knox-101/boldfit-gallon-cap/preview/02_vault_cap.png

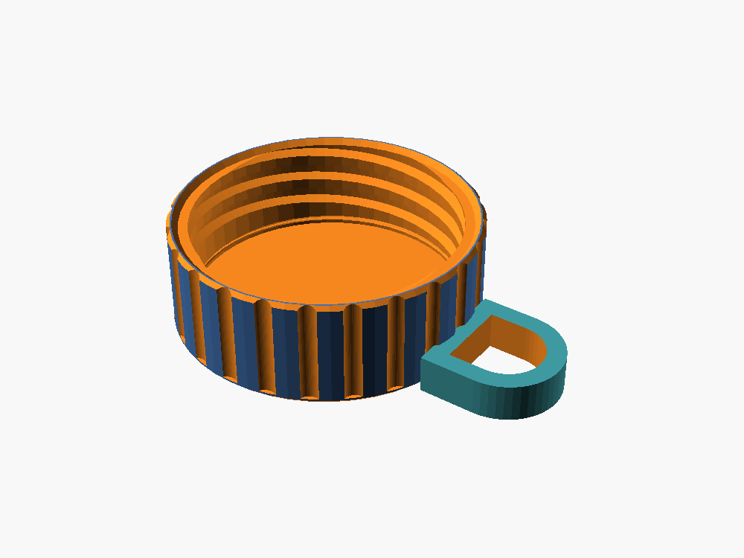
preview/02_vault_cap.png
