knox-101/boldfit-gallon-cap/preview/03_flip_base.png

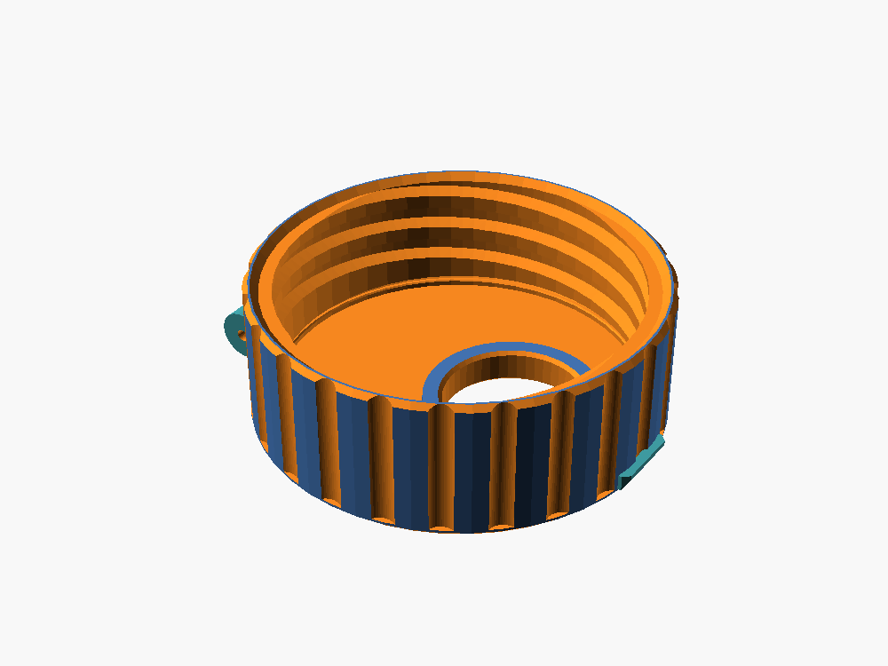
preview/03_flip_base.png
