knox-101/boldfit-gallon-cap/preview/03_flip_lid.png

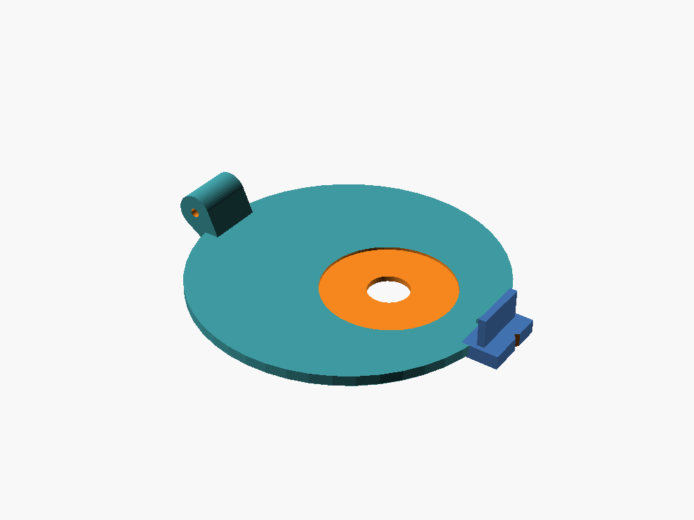
preview/03_flip_lid.png
