knox-101/boldfit-gallon-cap/preview/03_flip_seal_tpu.png

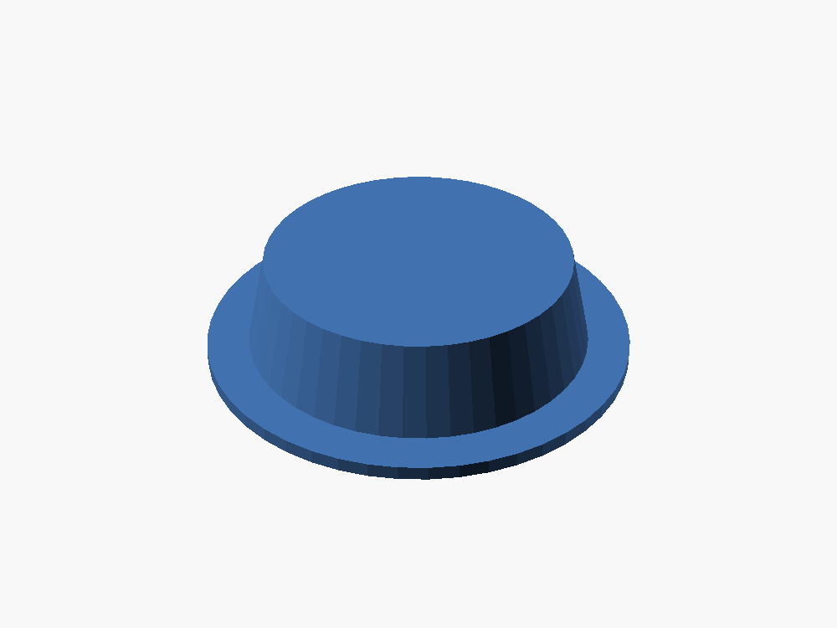
preview/03_flip_seal_tpu.png
