knox-101/boldfit-gallon-cap/preview/04_port_cap.png

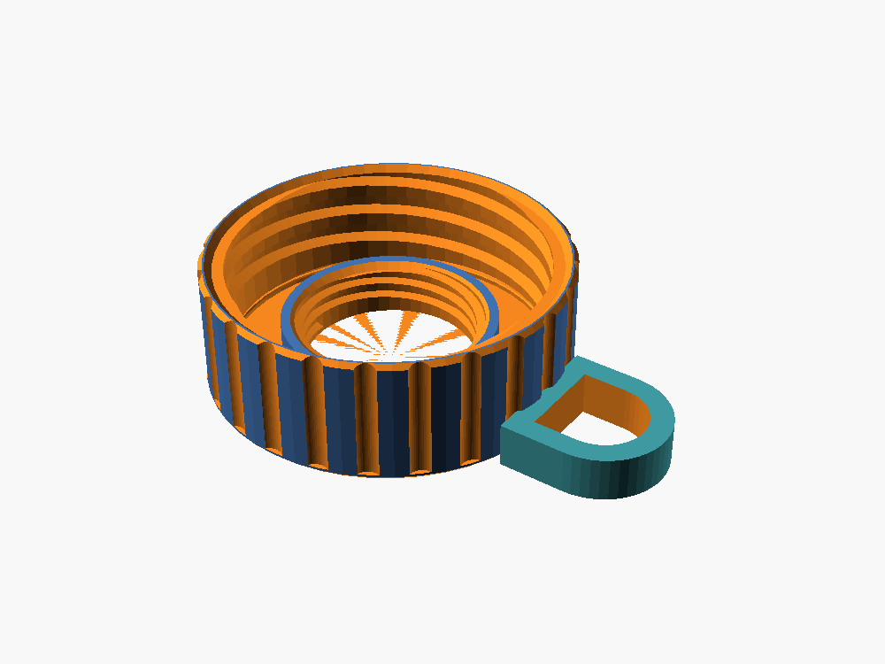
preview/04_port_cap.png
