knox-101/boldfit-gallon-cap/preview/04_port_gasket.png

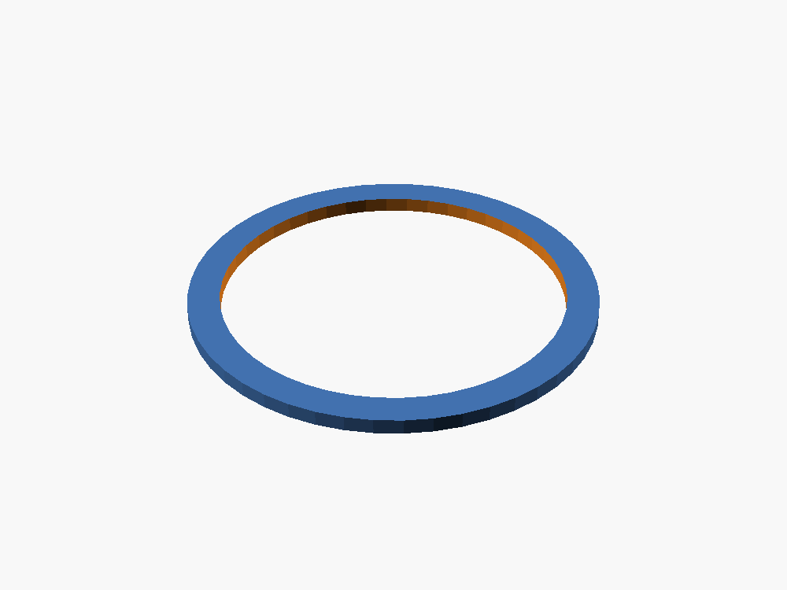
preview/04_port_gasket.png
