knox-101/boldfit-gallon-cap/preview/sections_2d.png

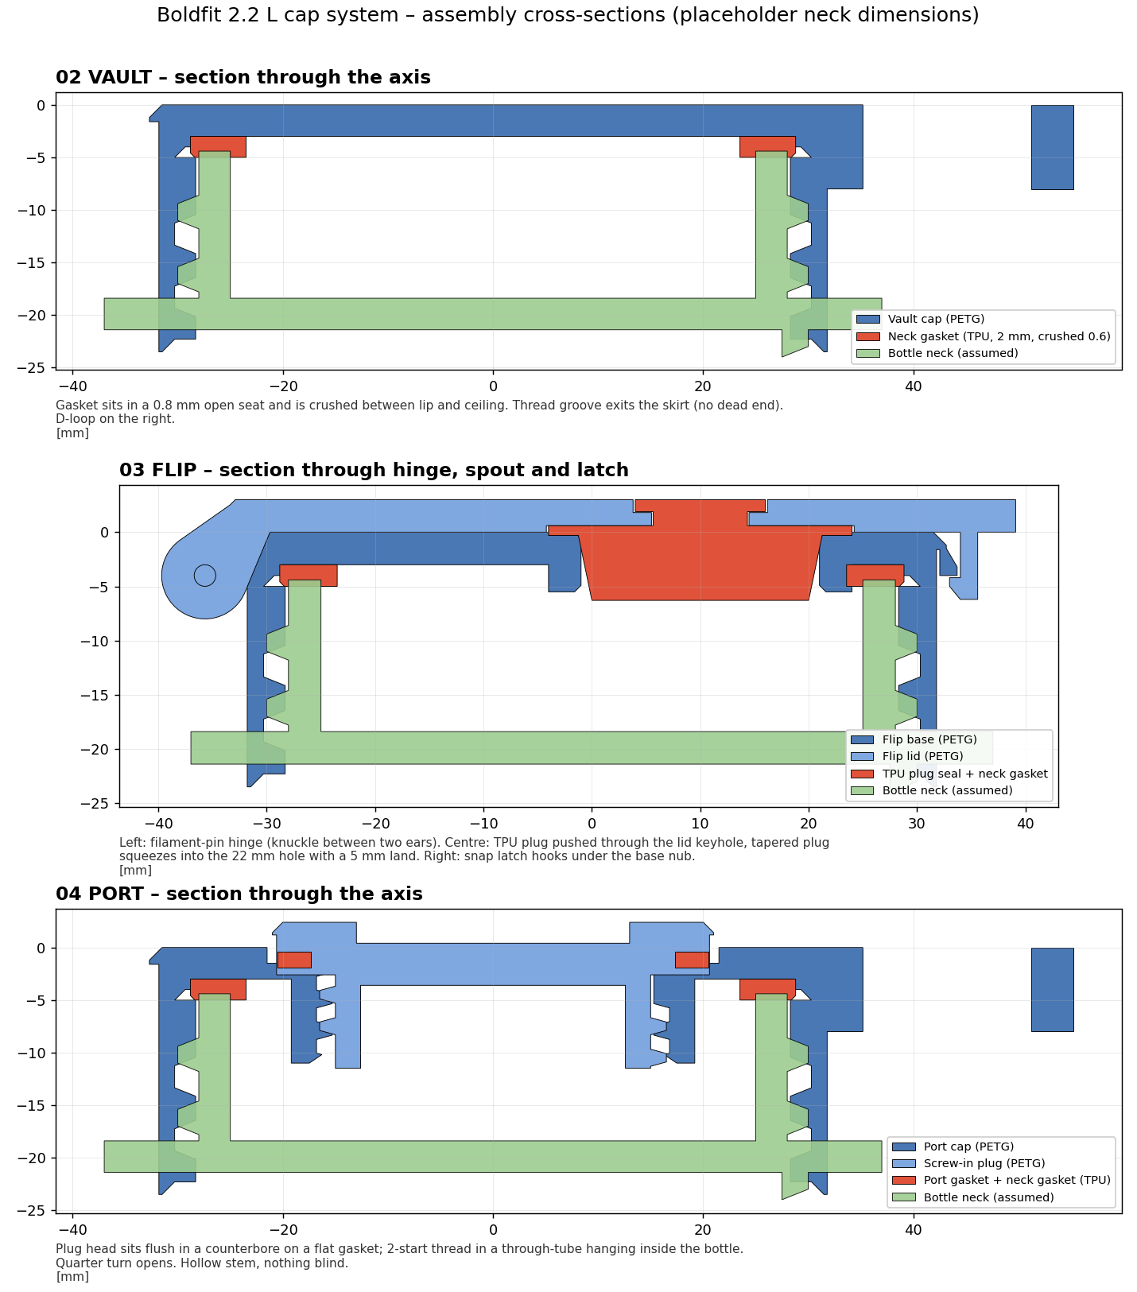
preview/sections_2d.png
