knox-101/boldfit-gallon-cap/preview/view_section_flip.png

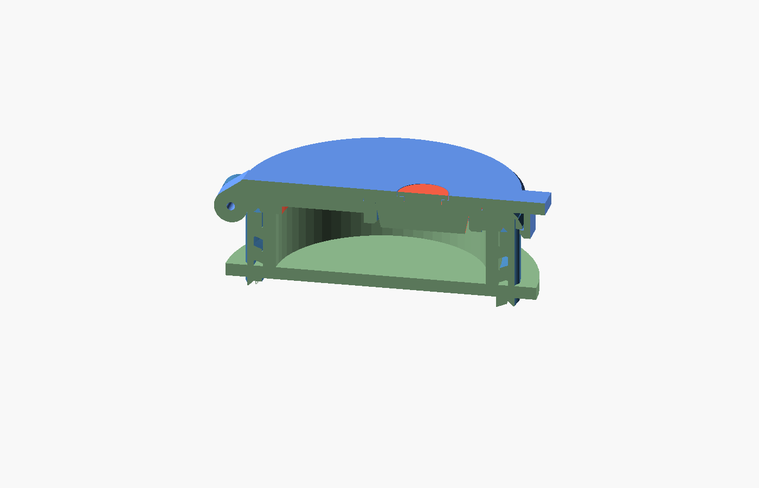
preview/view_section_flip.png
