knox-101/boldfit-gallon-cap/stl/neck_reference.stl

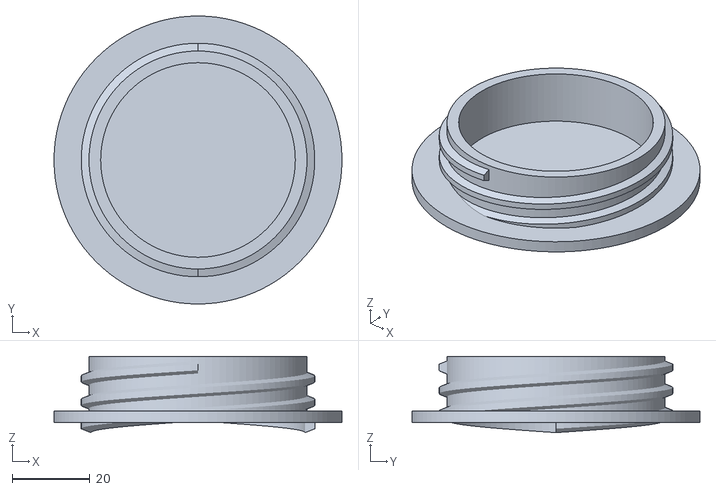
[picture p10: CAD file, 2026-10-17]
stl/neck_reference.stl
74.0 x 74.0 x 19.6
