knox-101/boldfit-gallon-cap/stl/04_port_gasket.stl

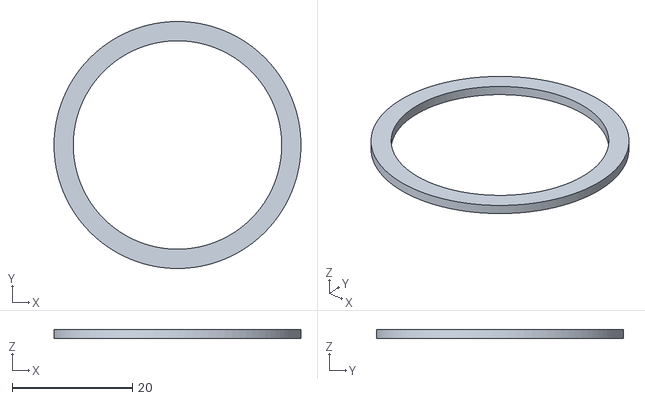
[picture p11: CAD file, 2026-10-17]
stl/04_port_gasket.stl
41.0 x 41.0 x 1.50
