knox-101/boldfit-gallon-cap/stl/03_flip_base.stl

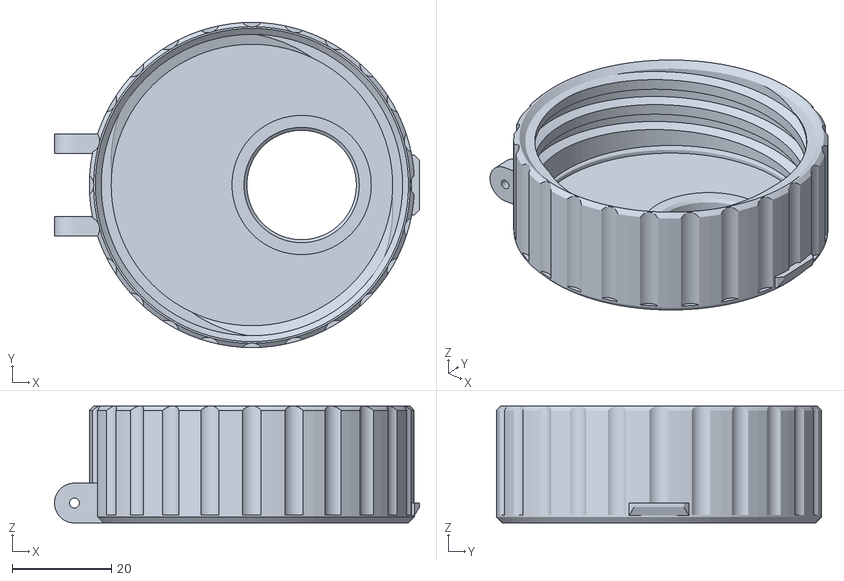
[picture p12: CAD file, 2026-10-17]
stl/03_flip_base.stl
73.4 x 65.4 x 23.5
