knox-101/boldfit-gallon-cap/stl/05_neck_gasket.stl

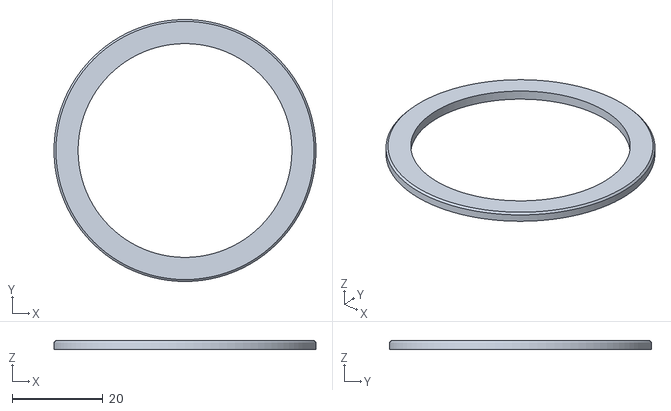
[picture p13: CAD file, 2026-10-17]
stl/05_neck_gasket.stl
57.6 x 57.6 x 2.00
