knox-101/boldfit-gallon-cap/stl/01_test_ring.stl

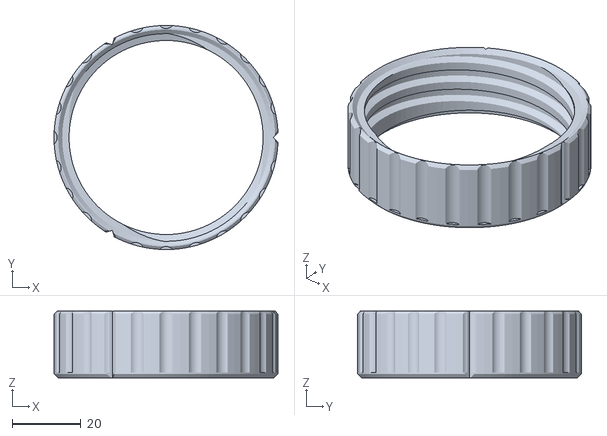
[picture p14: CAD file, 2026-10-17]
stl/01_test_ring.stl
65.4 x 65.4 x 19.5
