knox-101/boldfit-gallon-cap/stl/04_port_plug.stl

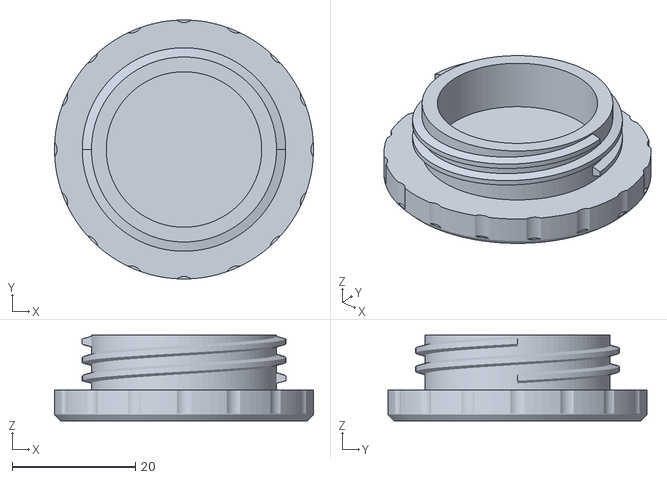
[picture p15: CAD file, 2026-10-17]
stl/04_port_plug.stl
42.0 x 42.0 x 13.9
