knox-101/boldfit-gallon-cap/stl/03_flip_seal_tpu.stl

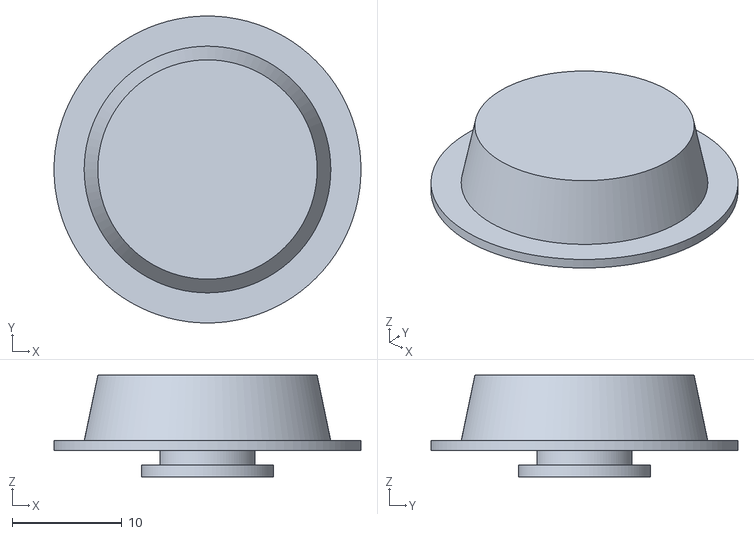
[picture p16: CAD file, 2026-10-17]
stl/03_flip_seal_tpu.stl
28.0 x 28.0 x 9.29
