knox-101/boldfit-gallon-cap/stl/03_flip_lid.stl

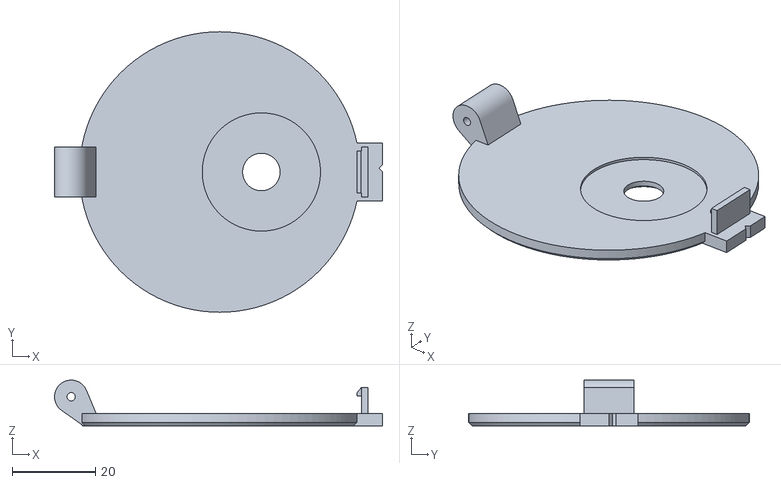
[picture p17: CAD file, 2026-10-17]
stl/03_flip_lid.stl
78.8 x 67.4 x 11.0
