knox-101/boldfit-gallon-cap/stl/02_vault_cap.stl

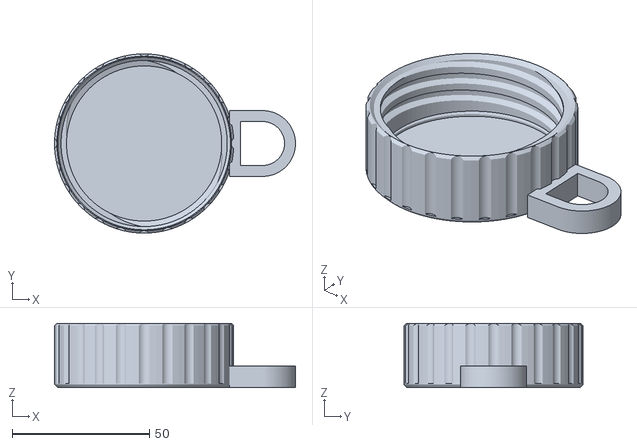
[picture p18: CAD file, 2026-10-17]
stl/02_vault_cap.stl
87.9 x 65.4 x 23.5
