knox-101/boldfit-gallon-cap/stl/04_port_cap.stl

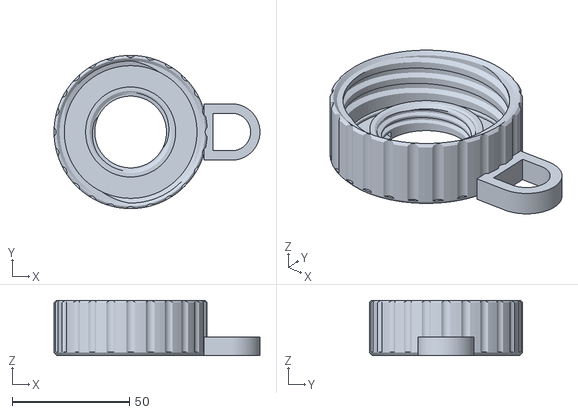
[picture p19: CAD file, 2026-10-17]
stl/04_port_cap.stl
87.9 x 65.4 x 23.5
