knox-101/boldfit-gallon-cap/scad/02_vault_cap.scad

// =====================================================================
//  02  "VAULT"  – plain leak-proof storage cap
//  Scalloped grip, D-loop for the Boldfit strap, removable flat gasket.
//  The simplest, most reliable cap: one part + one TPU/silicone gasket.
//  Geometry lives in parts.scad -> vault_cap()
// =====================================================================
include <parts.scad>
vault_cap(loop = true, top_text = "");   // top_text e.g. "2.2 L" is embossed into the bed face
