knox-101/boldfit-gallon-cap/scad/03_flip_base.scad

// =====================================================================
//  03a  "FLIP"  – flip-top drinking cap – BASE
//  Screw-on base with a 22 mm drinking hole, a hinge yoke and a latch nub.
//  Prints top-down, skirt up, no supports.
//  Pair with 03_flip_lid.scad + 03_flip_seal_tpu.scad.
//  Hinge pin = ~26 mm of 1.75 mm filament, melted flat at both ends.
//  Seal: the TPU plug on the lid presses into a plain cylindrical hole with
//  a 5 mm land – no groove, no O-ring, nothing to trap grime.
//  Numbers: 03_flip_common.scad   Geometry: parts.scad -> flip_base()
// =====================================================================
include <parts.scad>
flip_base();
