knox-101/boldfit-gallon-cap/scad/03_flip_lid.scad

// =====================================================================
//  03b  "FLIP"  – LID  (prints outer face down, no supports)
//  Rigid disc with a hinge knuckle, a snap latch and a KEYHOLE for the
//  removable TPU plug seal (03_flip_seal_tpu.scad) that pushes in from the
//  underside; its button shows on top as a coloured dot.
//  Tuning knobs: flip_tab_t, flip_hook_clear ... at the top of parts.scad
// =====================================================================
include <parts.scad>
flip_lid();
