knox-101/boldfit-gallon-cap/scad/03_flip_seal_tpu.scad

// =====================================================================
//  03c  "FLIP"  – TPU PLUG SEAL  (print in TPU 95A, 100 % infill, slow)
//  Flange sits in the lid's underside recess, the tapered plug squeezes into
//  the base's drinking hole, the stem+button pull through the lid keyhole and
//  hold it in place.  Pull the button to remove it for washing.
//  Print button-down (as modelled).  Tuning: flip_plug_squeeze in parts.scad
// =====================================================================
include <parts.scad>
flip_seal();
