knox-101/boldfit-gallon-cap/scad/04_port_gasket.scad

// 04c  "PORT" – flat TPU gasket under the plug head (print in TPU 95A)
include <parts.scad>
port_gasket();
