knox-101/boldfit-gallon-cap/scad/04_port_plug.scad

// =====================================================================
//  04b  "PORT"  – SCREW-IN PLUG  (prints head-down, no supports)
//  Flat head with a scalloped rim and a finger-bar recess, hollow male stem
//  with a 2-start thread (quarter turn open).  Gasket 04_port_gasket.scad
//  sits under the head.
// =====================================================================
include <parts.scad>
port_plug();
