knox-101/boldfit-gallon-cap/scad/05_neck_gasket.scad

// =====================================================================
//  05  NECK GASKET  – shared by Vault, Flip and Port caps
//  Print in TPU 95A (100 % infill, 0.2 mm layers, slow) – or use the STL as
//  a template to cut a ring from 2 mm food-grade silicone sheet.
//  OD is 0.4 mm larger than the seat so it clicks in and stays put, yet peels
//  out with a fingernail for washing.
// =====================================================================
include <parts.scad>
neck_gasket();
