knox-101/boldfit-gallon-cap/scad/neck_reference.scad

// Visual reference of the bottle neck as described in params.scad.
// Print this (optional) to compare with your real bottle before printing caps.
include <threads.scad>
neck_reference();
